tkp001/RCSkyhawkTrainer/media/Cessna 172 Skyhawk RC Build Blueprint.pdf

# Cessna 172 Skyhawk RC Build Blueprint

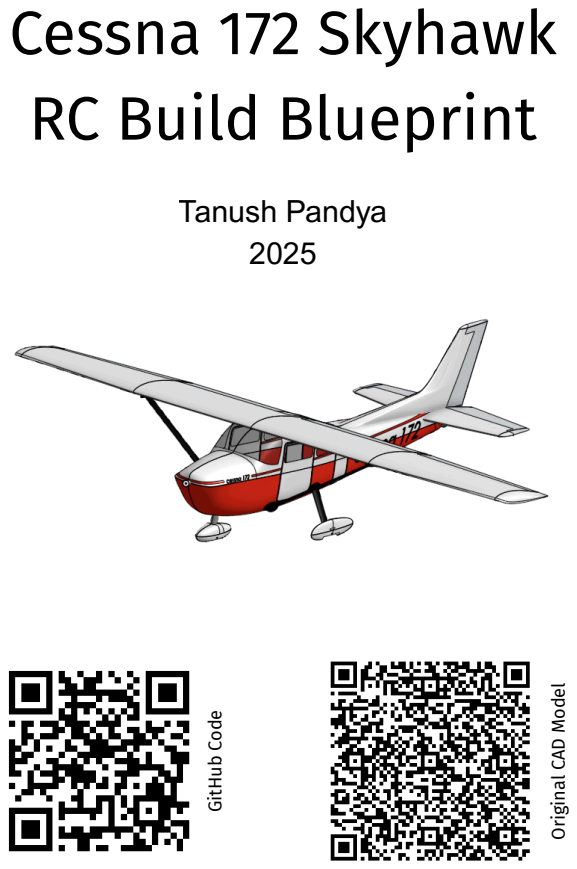
[picture p1: page 1]
Tanush Pandya 2025

# Notes

# Visuals are not to scale

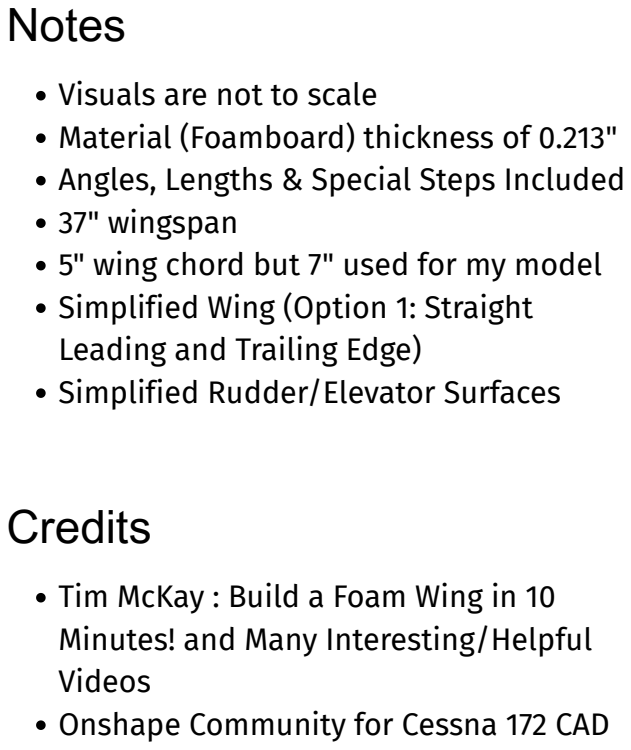
[picture p2: page 2]
Credits

Material (Foamboard) thickness of 0.213"
Angles, Lengths & Special Steps Included
37" wingspan
5" wing chord but 7" used for my model
Simplified Wing (Option 1: Straight
Leading and Trailing Edge)
Simplified Rudder/Elevator Surfaces

Tim McKay : Build a Foam Wing in 10
Minutes! and Many Interesting/Helpful
Videos
Onshape Community for Cessna 172 CAD

# Engine

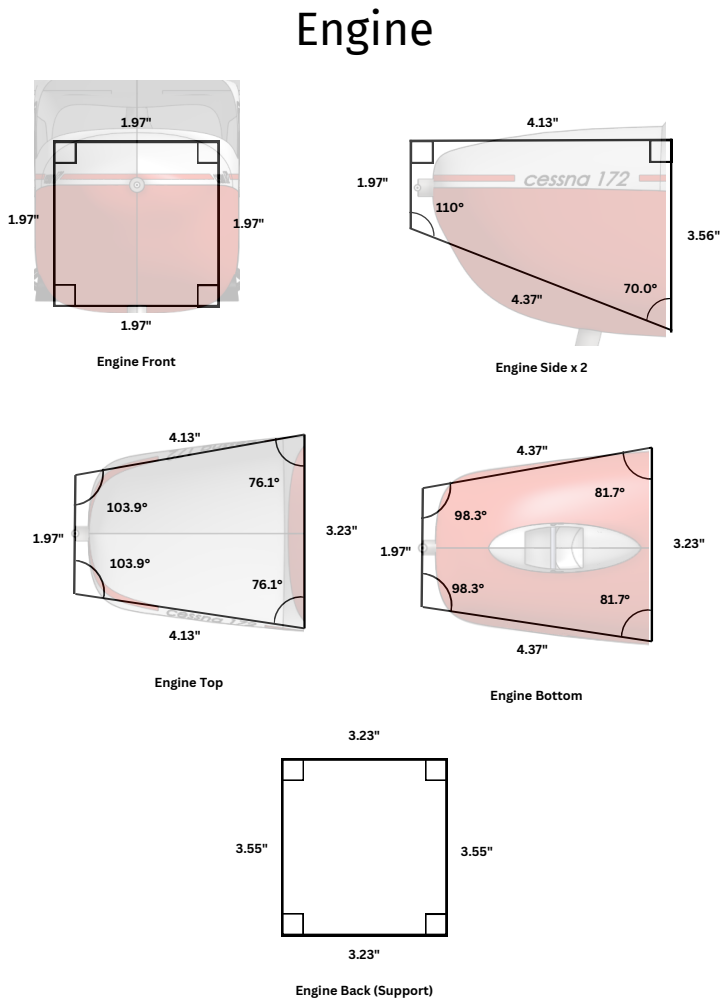
[picture p3: page 3]
Engine Front; Engine Side x 2; Engine Top; Engine Bottom

Engine Back (Support)

# Fuselage/Cockpit

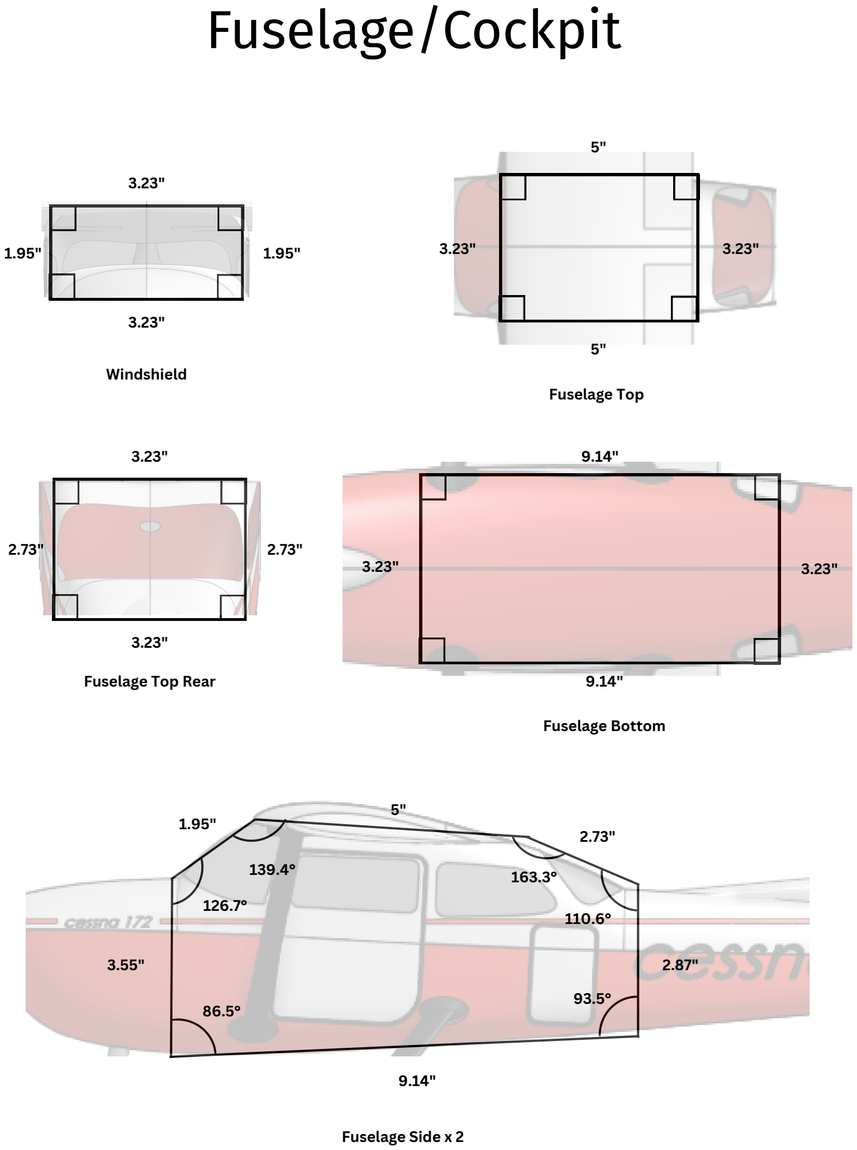
[picture p4: page 4]

139.4°

3.23"

1.95"

Windshield

1.95"

3.23"

5"

3.23"

Fuselage Top

3.23"

5"

3.23"

2.73"

Fuselage Top Rear

2.73"

3.23"

3.23"

9.14"

Fuselage Bottom

9.14"

3.23"

9.14"

3.55" | 2.87"

1.95"

5"
2.73"

Fuselage Side x 2

126.7°

86.5°

93.5°

110.6°

163.3°

# Tail Frame

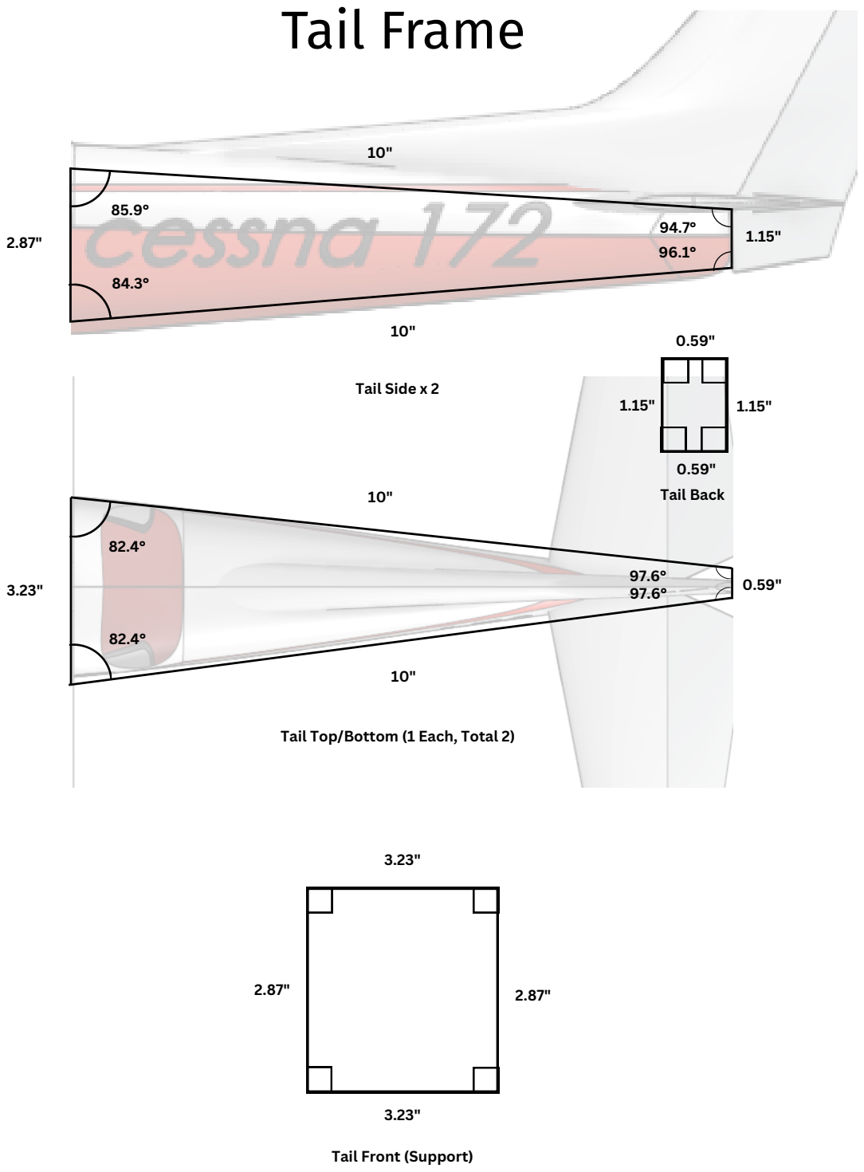
[picture p5: page 5]

2.87"

10"

1.15"

10"

Tail Side x 2

84.3°

85.9°

96.1°

94.7°

3.23"

10"

0.59"

10"

Tail Top/Bottom (1 Each, Total 2)

82.4°

82.4°

97.6°

97.6°

3.23"

2.87"

Tail Front (Support)

3.23"

2.87"

1.15"

Tail Back

0.59"

0.59"

1.15"

# Tail Controls

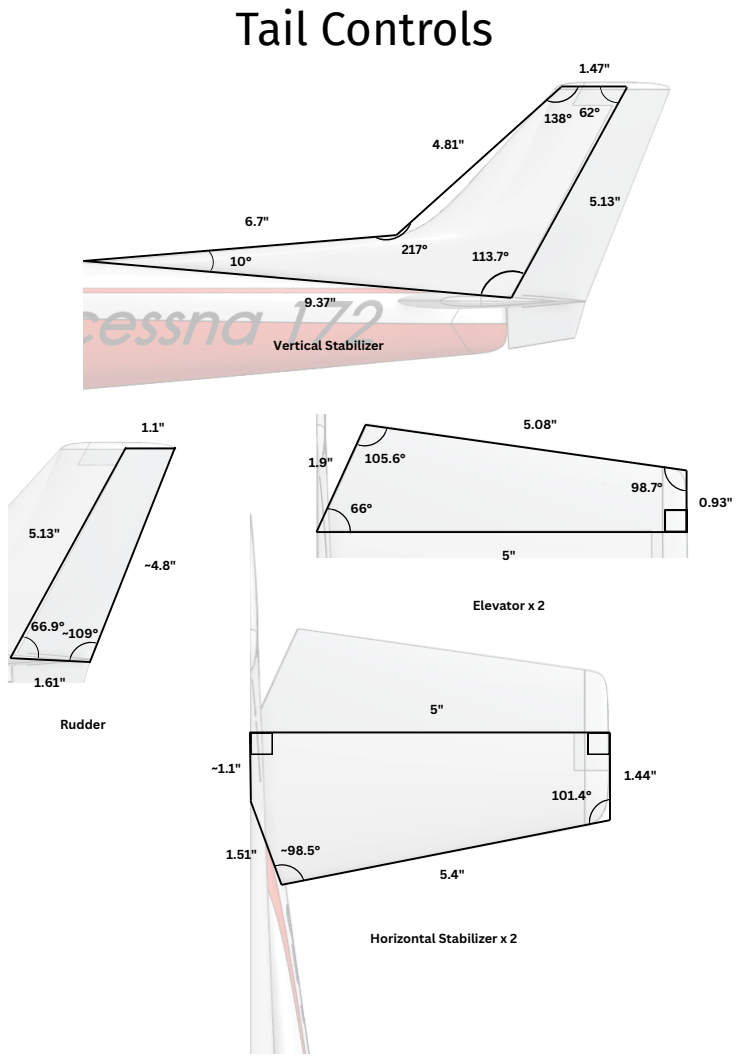
[picture p6: page 6]
Vertical Stabilizer; Rudder; Elevator x 2; Horizontal Stabilizer x 2

# Wing

## Watch Tim McKay : Build a Foam Wing in 10 Minutes!

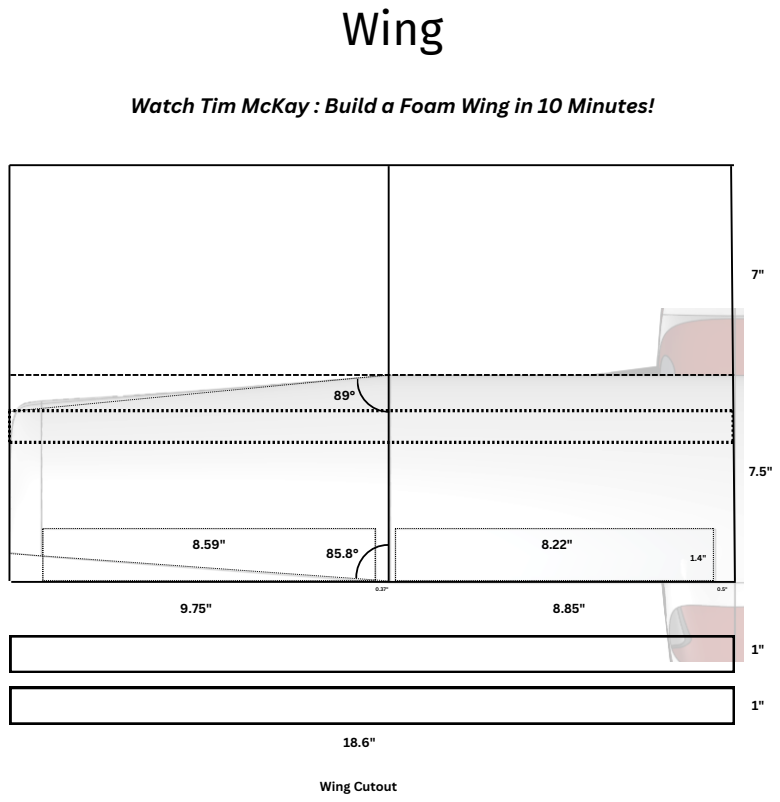
[picture p7: page 7]
Wing Cutout

# Cosmetics

Front/Back Wheel x 3

1"

3"

Back Wheel Dowel x 2

~7.65"

Wing Support Dowel x 2

0.53"

Front Wheel Dowel
