tkp001/RCSkyhawkTrainer/(commit log)

2025-08-15 basic beta script
    mostly functional. still in test phase. plane's parts mainly built and assembled but need further attention on wings, wheels, supports, motor mount etc.
2025-08-16 changed from madgwick filter to DMP6.
    external filter is no more!
2025-08-16 wiring diagram
    some pins may have been relocated, wiring1 does not include MPU6050 and other small DIY soldered circuits
2025-08-17 l1 button for manual ground calibration
2025-08-26 Add PID controller for autostabilization
2025-08-29 mimic rc style, throttle deadzone
    change controller to rc plane style, change right and left joystick corntolls to each other
2025-08-31 autostab updates.
    next is to fix gyro freezing
    [plane.ino]
